YoutechA320U/autoypiano/ESP32_BLE_autoypiano.ino

#include "BleMidi.h"
#include <Wire.h>
#include <MIDI.h>
#include <Adafruit_MCP23017.h>

BLEMIDI_CREATE_INSTANCE(bm);
MIDI_CREATE_INSTANCE(HardwareSerial, Serial2, MIDI);

Adafruit_MCP23017 mcp1;
Adafruit_MCP23017 mcp2;

int sole_sum = 0;
int sole_limit = 4; //ソレノイド発音数制限。作者の環境では4
int sole_on[] = {0,0,0,0,0,0,0,0,0,0,0,0,0,0,0,0,0,0,0,0,0,0,0,0,0};

int AdjustNote (int note) {
  if (note <= 101 && note >= 77) {
  } else if (note > 101) {
    do {
      note = note - 12;
    } while (note > 101);
  } else if (note < 77) {
    do {
      note = note + 12;
    } while (note < 77);
  }
  return note;
}
// -----------------------------------------------------------------------------
//
// -----------------------------------------------------------------------------
void setup(){
  Serial.begin(31250);
  //Serial.begin(115200);
  bm.begin("AuToyPiano");
  bm.setHandleNoteOn(OnBleMidiNoteOn);
  bm.setHandleNoteOff(OnBleMidiNoteOff);
  mcp1.begin(0);      //  MCP23017-1 use default address 0
  Wire.write(0x14);
  Wire.write(0x00); //0~7Pin LOW
  Wire.endTransmission();
  Wire.beginTransmission(0x20);
  Wire.write(0x15);
  Wire.write(0x00); //8~15Pin LOW
  Wire.endTransmission();
  mcp1.pinMode(0, OUTPUT);
  mcp1.pinMode(1, OUTPUT);
  mcp1.pinMode(2, OUTPUT);
  mcp1.pinMode(3, OUTPUT);
  mcp1.pinMode(4, OUTPUT);
  mcp1.pinMode(5, OUTPUT);
  mcp1.pinMode(6, OUTPUT);
  mcp1.pinMode(7, OUTPUT);
  mcp1.pinMode(8, OUTPUT);
  mcp1.pinMode(9, OUTPUT);
  mcp1.pinMode(10, OUTPUT);
  mcp1.pinMode(11, OUTPUT);
  mcp1.pinMode(12, OUTPUT);
  mcp1.pinMode(13, OUTPUT);
  mcp1.pinMode(14, OUTPUT);
  mcp1.pinMode(15, OUTPUT);
  mcp2.begin(1);      // MCP23017-2 use address 1
  Wire.beginTransmission(0x21);
  Wire.write(0x14);
  Wire.write(0x00); //0~7Pin LOW
  Wire.endTransmission();
  Wire.beginTransmission(0x21);
  Wire.write(0x15);
  Wire.write(0x00); //8~15Pin LOW
  Wire.endTransmission();
  mcp2.pinMode(0, OUTPUT);
  mcp2.pinMode(1, OUTPUT);
  mcp2.pinMode(2, OUTPUT);
  mcp2.pinMode(3, OUTPUT);
  mcp2.pinMode(4, OUTPUT);
  mcp2.pinMode(5, OUTPUT);
  mcp2.pinMode(6, OUTPUT);
  mcp2.pinMode(7, OUTPUT);
  mcp2.pinMode(8, OUTPUT);
  MIDI.begin(1);
}


void OnBleMidiNoteOn(byte channel, byte note, byte velocity) {
  //Serial.print(channel);
  //Serial.print(note);
  //Serial.print(velocity);
  note = AdjustNote(note);
  if (note == 77 and sole_sum < sole_limit and sole_on[0] ==0) {
    mcp1.digitalWrite(0, HIGH);
    sole_on[0] =1;
    sole_sum = sole_sum + 1;
  } else if (note == 78 and sole_sum < sole_limit and sole_on[1] ==0) {
    mcp1.digitalWrite(1, HIGH);
    sole_on[1] =1;
    sole_sum = sole_sum + 1;
  } else if (note == 79 and sole_sum < sole_limit and sole_on[2] ==0) {
    mcp1.digitalWrite(2, HIGH);
    sole_on[2] =1;
    sole_sum = sole_sum + 1;
  } else if (note == 80 and sole_sum < sole_limit and sole_on[3] ==0) {
    mcp1.digitalWrite(3, HIGH);
    sole_on[3] =1;
    sole_sum = sole_sum + 1;
  } else if (note == 81 and sole_sum < sole_limit and sole_on[4] ==0) {
    mcp1.digitalWrite(4, HIGH);
    sole_on[4] =1;
    sole_sum = sole_sum + 1;
  } else if (note == 82 and sole_sum < sole_limit and sole_on[5] ==0) {
    mcp1.digitalWrite(5, HIGH);
    sole_on[5] =1;
    sole_sum = sole_sum + 1;
  } else if (note == 83 and sole_sum < sole_limit and sole_on[6] ==0) {
    mcp1.digitalWrite(6, HIGH);
    sole_on[6] =1;
    sole_sum = sole_sum + 1;
  } else if (note == 84 and sole_sum < sole_limit and sole_on[7] ==0) {
    mcp1.digitalWrite(7, HIGH);
    sole_on[7] =1;
    sole_sum = sole_sum + 1;    
  } else if (note == 85 and sole_sum < sole_limit and sole_on[8] ==0) {
    mcp1.digitalWrite(8, HIGH);
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
    } if (rx != 0 and (rx1 == 128 and rx2 == 101)  or (rx1 == 144 and rx2 == 101 and rx3 ==0)and sole_on[24] ==1) {
      mcp2.digitalWrite(8, LOW);
      sole_on[24] =0;
      sole_sum = sole_sum - 1;
    } if (sole_sum < 0) { 
      sole_sum = 0;
    } else {
    }
  } while (rx !=0);
}
