YoutechA320U/autoypiano/TOYPIANO.BAS

SERIAL 32150,0
I2C 100
I2CWRITE $20,$0,$0
I2CWRITE $20,$01,$0
I2CWRITE $21,$0,$0
I2CWRITE $21,$01,$0
I2CWRITE $20,$14,$0
I2CWRITE $20,$15,$0
I2CWRITE $21,$14,$0
I2CWRITE $20,$15,$0
A=0:B=0:C=0:D=0
WHILE 1
   IF INKEY()=27 THEN BREAK
   I=SERIALIN()
   IF I=-1 THEN CONTINUE
   IF I=128 THEN
    J=I
    CONTINUE
   ELSEIF I=144 THEN
    K=I
    CONTINUE
   ELSEIF J=128 THEN
     L=I
     J=0
     CONTINUE
   ELSEIF L=77 THEN
     L=-2
     A=A AND 254
     I2CWRITE $20,$14,A
   ELSEIF L=78 THEN
     L=-2
     A=A AND 253
     I2CWRITE $20,$14,A
   ELSEIF L=79 THEN
     L=-2
     A=A AND 251
     I2CWRITE $20,$14,A
   ELSEIF L=80 THEN
     L=-2
     A=A AND 247
     I2CWRITE $20,$14,A
   ELSEIF L=81 THEN
     L=-2
     A=A AND 239
     I2CWRITE $20,$14,A
   ELSEIF L=82 THEN
     L=-2
     A=A AND 223
     I2CWRITE $20,$14,A
   ELSEIF L=83 THEN
     L=-2
     A=A AND 191
     I2CWRITE $20,$14,A
   ELSEIF L=84 THEN
     L=-2
     A=A AND 127
     I2CWRITE $20,$14,A
   ELSEIF L=85 THEN
     L=-2
     B=B AND 254
     I2CWRITE $20,$15,B
   ELSEIF L=86 THEN
     L=-2
     B=B AND 253
     I2CWRITE $20,$15,B
   ELSEIF L=87 THEN
     L=-2
     B=B AND 251
     I2CWRITE $20,$15,B
   ELSEIF L=88 THEN
     L=-2
     B=B AND 247
     I2CWRITE $20,$15,B
   ELSEIF L=89 THEN
     L=-2
     B=B AND 239
     I2CWRITE $20,$15,B
   ELSEIF L=90 THEN
     L=-2
     B=B AND 223
     I2CWRITE $20,$15,B
   ELSEIF L=91 THEN
     L=-2
     B=B AND 191
     I2CWRITE $20,$15,B
   ELSEIF L=92 THEN
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
     C=C OR 32
     I2CWRITE $21,$14,C
   ELSEIF M=99 THEN
     M=-2
     C=C OR 64
     I2CWRITE $21,$14,C
   ELSEIF M=100 THEN
     M=-2
     C=C OR 128
     I2CWRITE $21,$14,C
   ELSEIF M=101 THEN
     M=-2
     D=D OR 1
     I2CWRITE $21,$15,D
   ELSE
     N=I
     CONTINUE
   ENDIF
WEND
