YoutechA320U/autoypiano/(commit log)

2018-12-07 新規作成
2019-03-08 MachiKaniaに対応
2019-03-08 MachiKaniaにも対応
2023-04-30 Update autoypiano.ino
    ノートオフ3バイト目を見る仕様から見ないよう変更しました
2023-04-30 Update autoypiano_usb.ino
    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
2023-04-30 Update M5autoypiano.ino
    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
2023-04-30 Update autoypiano.ino
    MIDI1.0準拠のため修正
2023-04-30 Update autoypiano_usb.ino
    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
2023-04-30 Update ESP32_BLE_autoypiano.ino
    MIDI1.0準拠のため修正(試験的)
2023-04-30 Update M5autoypiano.ino
    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
2023-04-30 MIDI1.0準拠に修正
